hglr24/EpicWebHero/README.md

## Epic Web Hero  

### Harry Ross (hgr8) and Carrie Hunner (clh87)  
### ECE 350 - Digital Systems  

See technical report PDF in design/ for design breakdown and playing instructions.
