hglr24/EpicWebHero/design/circuits/trigger_and_photoresistor_schematics.pdf

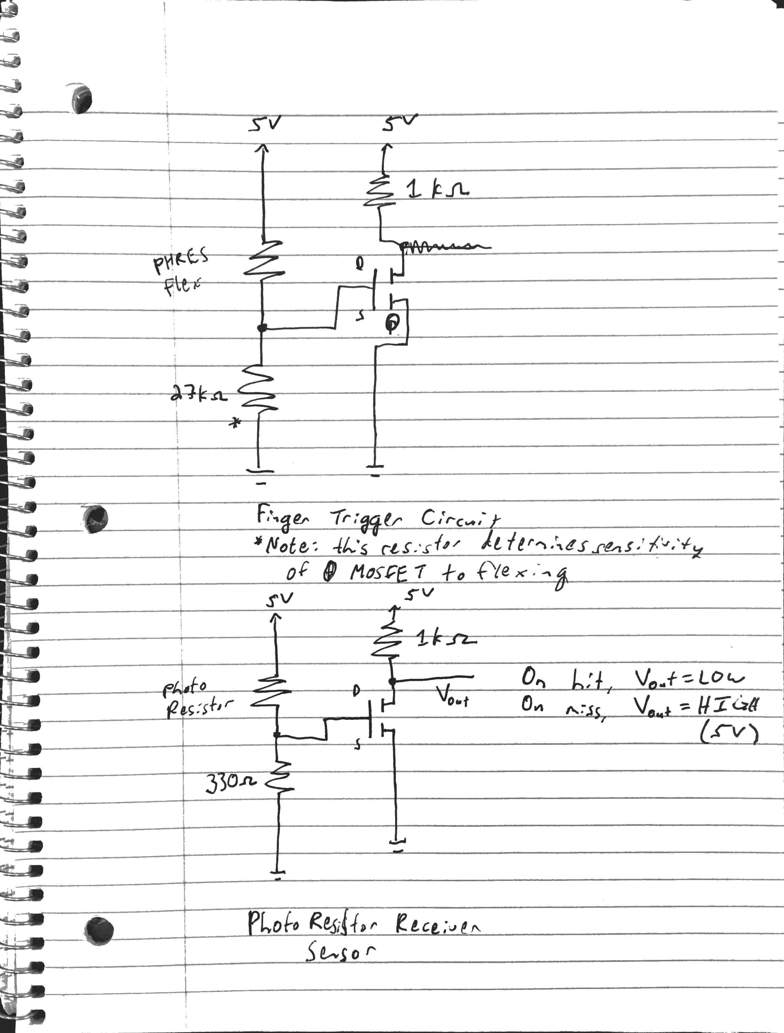
[picture p11: page 1]
