hglr24/EpicWebHero/design/laser_cutter_files/Cityscape Sketch.pdf

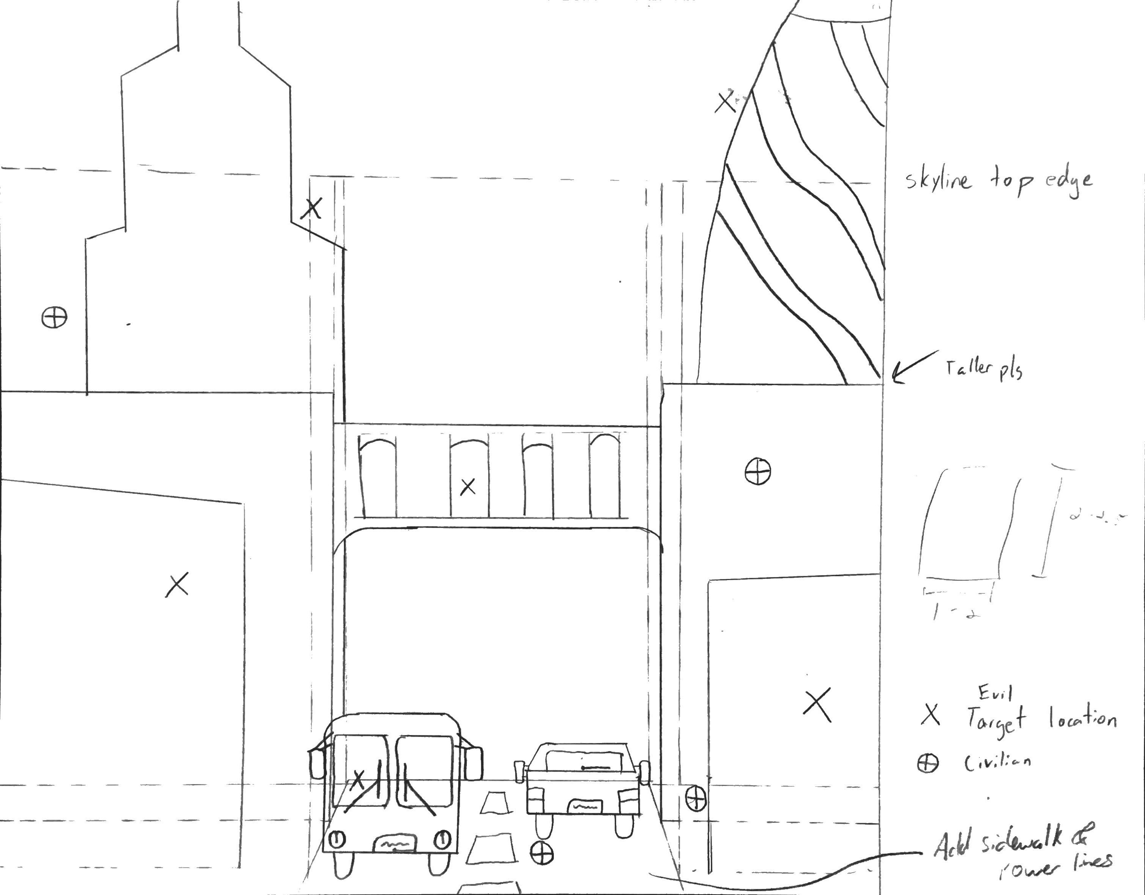
[picture p12: page 1]
