hglr24/EpicWebHero/design/3d_models/laser_tube_extender_single.stl

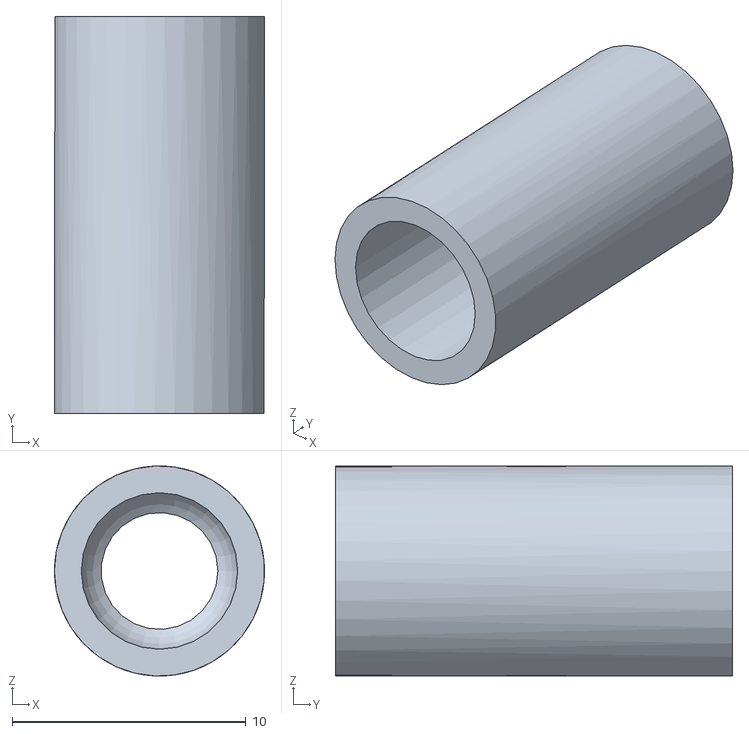
[picture p13: CAD file, 2019-11-23]
design/3d_models/laser_tube_extender_single.stl
9.00 x 17.0 x 8.99
