hglr24/EpicWebHero/design/3d_models/laser_tube_extender.stl

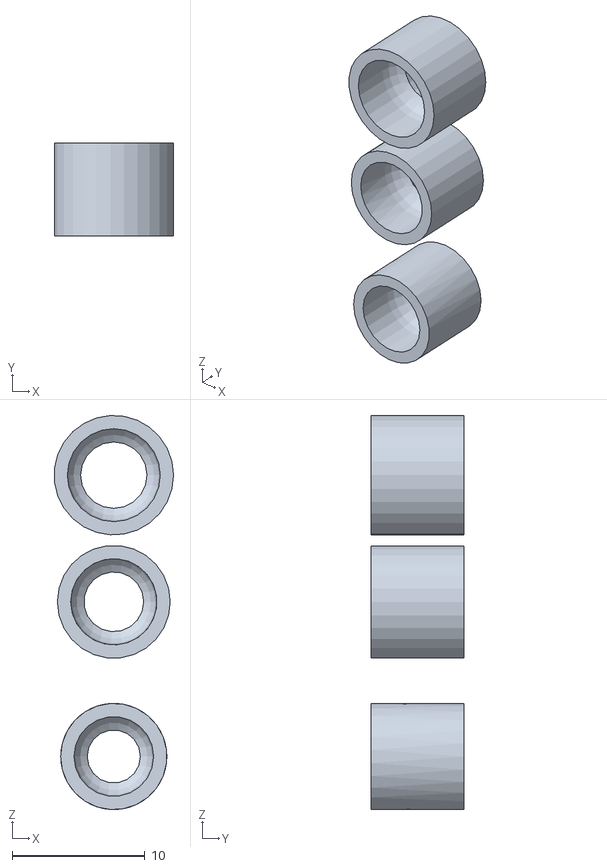
[picture p14: CAD file, 2019-11-23]
design/3d_models/laser_tube_extender.stl
8.97 x 7.00 x 29.7
