hglr24/EpicWebHero/design/3d_models/laser_batch.stl

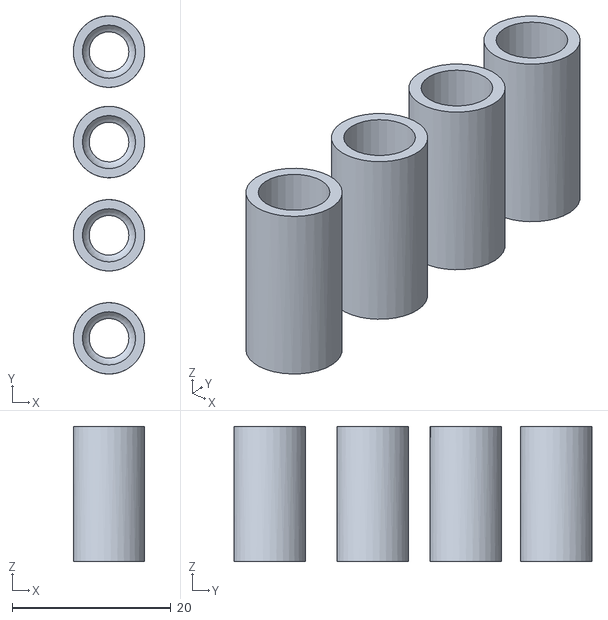
[picture p15: CAD file, 2019-11-23]
design/3d_models/laser_batch.stl
9.00 x 45.1 x 17.0
