hglr24/EpicWebHero/design/3d_models/bracket.stl

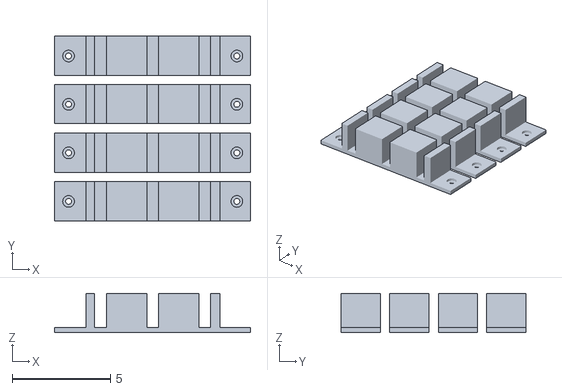
[picture p16: CAD file, 2019-11-15]
design/3d_models/bracket.stl
10.0 x 9.42 x 2.00
