hglr24/EpicWebHero/(list of files, cad)

Other CAD files:
design/3d_models/OldVersions/laser_tube_extender.0001.ipt
design/3d_models/board bracket.blend
design/3d_models/bracket.blend
design/3d_models/laser_batch.blend
design/3d_models/laser_tube_extender.ipt
design/3d_models/laser_tube_extender_single.ipt
