hglr24/EpicWebHero/processor/right_shift16.v

module right_shift16(in, out);

	input [31:0] in;
	output [31:0] out;
	
	// perform 16-bit right arithmetic shift
	
	assign out[0] = in[16];
	assign out[1] = in[17];
	assign out[2] = in[18];
	assign out[3] = in[19];
	assign out[4] = in[20];
	assign out[5] = in[21];
	assign out[6] = in[22];
	assign out[7] = in[23];
	assign out[8] = in[24];
	assign out[9] = in[25];
	assign out[10] = in[26];
	assign out[11] = in[27];
	assign out[12] = in[28];
	assign out[13] = in[29];
	assign out[14] = in[30];
	assign out[15] = in[31];
	
	// extend MSD
	
	assign out[16] = in[31];
	assign out[17] = in[31];
	assign out[18] = in[31];
	assign out[19] = in[31];
	assign out[20] = in[31];
	assign out[21] = in[31];
	assign out[22] = in[31];
	assign out[23] = in[31];
	assign out[24] = in[31];
	assign out[25] = in[31];
	assign out[26] = in[31];
	assign out[27] = in[31];
	assign out[28] = in[31];
	assign out[29] = in[31];
	assign out[30] = in[31];
	assign out[31] = in[31];

endmodule
