hglr24/EpicWebHero/(commit log)

2019-11-15 Added design folder
    [bracket.blend, bracket.stl]
2019-11-16 copied over laser cutter design files
2019-11-16 uploaded laser cutter files and circuit schematics
2019-11-17 created a timer module - currently untested because waveforms dont go up to 1 second, need to test with FPGA and some physical output
2019-11-23 uploaded 3d printing models for laser tube extender
    [laser_tube_extender.0001.ipt, laser_tube_extender.ipt, laser_tube_extender.stl, laser_tube_extender_single.ipt, laser_tube_extender_single.stl]
2019-11-23 created laser cutter files for second round of targets
2019-11-24 json file for new instruction types is working, created a file for testing the timer instruction
2019-11-24 created s file for testing timer
2019-11-24 created a tester script for randn and timera, timerb, timerc
2019-11-25 Added score converter module, created doc for pin assignments, implemented laser drivers with proper IO
2019-11-26 added to script to check if time is up, added the fourth civilian, checking if reset button is pressed;
2019-11-26 Added test files and fixed score converter
    [board bracket.blend]
2019-11-29 randn tested and working, heavily modified regfile to give it backdoors, implemented timer insts but untested
2019-11-30 adjusted timer instructions to be JII type
2019-12-01 Verified timer instructions as much as I could. There are a bunch of irrelevant outputs on things for testing sorry
2019-12-01 edited and improved full script, it is able to be compiled by the assembler
2019-12-03 inserted nops after each timer that needs it
2019-12-03 added a counter reset for the rand module
    [random_num_gen.v]
2019-12-04 created a MIPs script to test timer
2019-12-04 Added halt instruction to prevent MIPS programs from looping to beginning
    [epic_web_hero.v, inst_decoder.v, processor.v]
2019-12-05 pretty sure I fixed the problem with the timer offset at the start
